Infinest/GENESIS2PCE/Images/boardv1.jpg

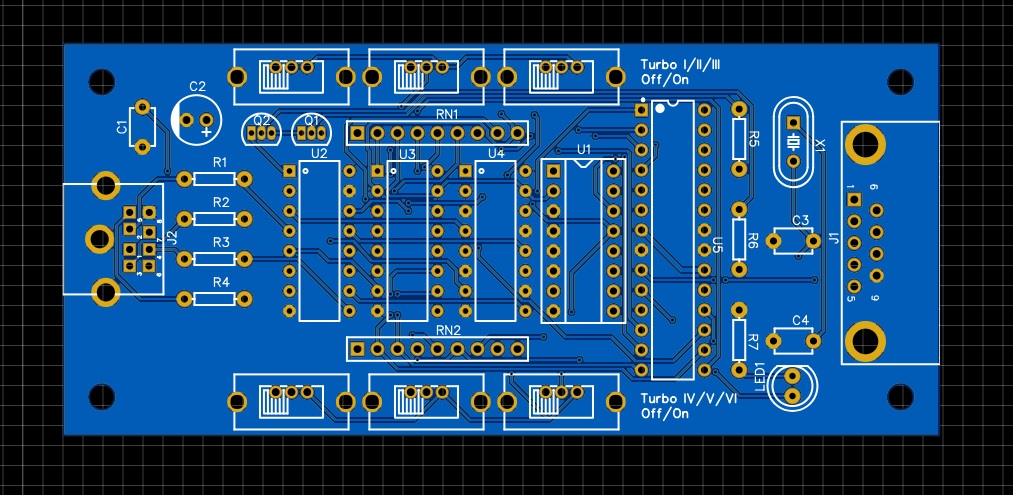
Images/boardv1.jpg
