Infinest/GENESIS2PCE/BOM/GENESIS2PCE v3.xlsx

Designator | Manufacturer | MPN | QTY | Description | Value | Package | URL
J1 | TE Connectivity | 2301843-1 | 1 | Male 9 pin D-Sub connector | - | - | https://www.mouser.com/ProductDetail/TE-Connectivity/2301844-2
J2 | TE Connectivity | 5749268-1 | 1 | Female 8 pin Mini DIN connector | - | - | https://www.mouser.com/ProductDetail/TE-Connectivity-AMP/5749268-1?qs=BU%252BKxOECzi7rjBKKXjFTsQ==
U1 | Texas Instruments | SN74LS163AN | 1 | Synchronous 4-Bit counter | - | DIP-16 | https://www.mouser.com/ProductDetail/Texas-Instruments/SN74LS163AN
U2, U3, U4 | Texas Instruments | SN74LS157N | 3 | Quadruple 2-Line To 1-Line Data Selector/Multiplexer | - | DIP-16 | https://www.mouser.com/ProductDetail/Texas-Instruments/SN74LS157N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
U5 | Microchip Technology / Atmel | 556-ATMEGA328P-PU | 1 | 8-bit Microcontroller | - | DIP-28 | https://mouser.com/ProductDetail/Microchip-Technology-Atmel/ATMEGA328P-PU?qs=K8BHR703ZXguOQv3sKbWcg%3D%3D
Turbo I, II, III, IV, V, VI, Turbo Speed | ALPS | SSSF012100 | 7 | Slide Switch | - | - | https://www.mouser.com/ProductDetail/ALPS/SSSF012100?qs=uROlC5LSwk237c%2FgvLDF5g==
Q1, Q2 | ON Semiconductor | 2N3904BU | 2 | Bipolar Transistor | - | TO-92 | https://www.mouser.com/ProductDetail/ON-Semiconductor-Fairchild/2N3904BU?qs=sGAEpiMZZMtdAabcSkQOlwCadH2Rvktn
X1 | ESC | ECS-160-20-4X | 1 | Quartz Crystal | 16MHz | Radial | https://www.mouser.com/ProductDetail/ECS/ECS-160-20-4X?qs=sGAEpiMZZMsBj6bBr9Q9aVer1RMgfDjszS79egocOZw%3D
C1 | KEMET | C315C470K5G5TA | 1 | Multilayer Ceramic Capacitor | 47pF +/- 10% 50V | Radial | https://www.mouser.com/ProductDetail/KEMET/C315C470K5G5TA
C2 | Nichicon | UPJ1C101MED1TA | 1 | Aluminium Electrolytic Capacitor | 100uF +/- 20% 16V | Radial | https://mouser.com/ProductDetail/Nichicon/UPJ1C101MED1TA
C3, C4 | KEMET | C316C200K5G5TA7301 | 2 | Multilayer Ceramic Capacitor | 20pF +/- 10% 50V | Radial | https://www.mouser.com/ProductDetail/KEMET/C316C200K5G5TA7301
RN1, RN2 | Bourns | 4609M-101-473LF | 2 | Bussed Resistor Network | 47kOhm, 0.25W | SIP | https://www.mouser.com/ProductDetail/Bourns/4609M-101-473LF
R1, R2, R3, R4, R7 | Vishay | SFR2500003300FR500 | 5 | Metal Film Resistor | 330Ohm, 0.4W | Axial | https://mouser.com/ProductDetail/Vishay-BC-Components/SFR2500003300FR500?qs=LCMWAU1DZcw08XqYmTIKfg%3D%3D
R5, R6 | Vishay | MBB02070C4702FC100 | 2 | Metal Film Resistor | 47kOhm, 0.6W | Axial | https://mouser.com/ProductDetail/Vishay-Beyschlag/MBB02070C4702FC100?qs=LkqrmUh5PIL1tFbBvDgMbA%3D%3D
R8, R9, R10, R11, R12, R13, R14 | Vishay | MBB02070C1001FCT00 | 7 | Metal Film Resistor | 1kOhm, 0.6W | Axial | https://mouser.com/ProductDetail/Vishay-Beyschlag/MBB02070C1001FCT00?qs=Jr4%2Ft4s12JXLzvxfb19GWA%3D%3D
D1, D2, D3, D4, D5, D6 | STMicroelectronics | 511-BAT41 | 6 | Schottky Diodes | 100mA 100V | Axial | https://mouser.com/ProductDetail/STMicroelectronics/BAT41?qs=JV7lzlMm3yLsDyxobuLK1w==
LED1 | Lumex | 696-SSLLX5093GD-5V | 1 | LED | Green 5V 12mA | Radial | https://mouser.com/ProductDetail/Lumex/SSL-LX5093GD-5V?qs=sWJIHVaBZlAPrsb12LmXaQ%3D%3D
