Infinest/GENESIS2PCE/Hex/Changelog.md

# Changelog
### v1
- Initial code for prototype board
---
### v2
- Change pinout to fit board revision 2
---
### v3
- Change pinout to fit board revision 3
---
### v3.1
- Lower delay inbetween read cycles to 2 ms
----
### v3.2
- Add button combination to swap Run and Select assignment (A, B, C & Start)
