Infinest/GENESIS2PCE/(commit log)

2020-06-13 Update Pin assignments for new PCB
2020-06-13 Add image and gerber files for v3
2020-06-13 Add BOM for v3
    [GENESIS2PCE v3.xlsx]
2020-06-14 Update GENESIS2PCE v3.xlsx
    [GENESIS2PCE v3.xlsx]
2020-06-21 Add button combination for swapping Run and Select assignment
    [main.c, main.h]
2020-06-21 Add current hex file
2020-08-24 Update main.h
    MS_DELAY 2 does not work with some chinese aftermarket controllers
    [main.h]
